ryanguo13/F1-60_722_clone/docs/PRODUCTION.md

# F1-60 722 clone — 打印与装配

WKL 60%，7.22° 楔形，嘉立创 FDM。外形对齐 Launcher 60 / F2-60，
前后壁加厚到 16 mm 以放下热熔螺母（见 [DESIGN.md](DESIGN.md)）。

## `out/` 当前件

| 文件 | 尺寸 (mm) | 说明 |
| --- | --- | --- |
| `PLATE.stl` | 285.75 × 96.10 × 1.5 | WKL ANSI，62 × 14×14 轴孔，6 个 Cherry 卫星轴槽 |
| `BOTTOM.stl` | 299.20 × 129.20 × 24.37 | 楔形底壳，2 mm 底板，前/后各 2 个 14×14 M3 热熔垫（Ø3.6 × 5.0），两条脚垫槽，后壁 USB |
| `TOP.stl` | 299.20 × 129.20 × 24.3（分型 8 → 打字 32.37） | 楔形上盖，键窗，左右桨式托台，后沿横条凹台，M3 通孔 Ø3.4 |
| `BAR.stl` | 296.20 × 8 × 3 | 后横条，无 logo，摩擦进上盖凹台 |

PCB：waffling60-DB / 任意 GH60 + ai03 UDB-C（18 × 16.5，M2 14 × 12.5）。

## 热熔（从 X4）

- 螺母：嘉立创 `M3*4*3`（Ø4 × L3）
- 打印底孔：Ø3.6 × 5.0，从 **BOTTOM 底面**开口，代嵌
- 垫：14 × 14，孔周壁 (14 − 3.6)/2 = 5.2 ≥ 3.0
- 螺钉：M3×8～10 盘头，上盖通孔 Ø3.4
- 位置：前唇 y=8、后沿 y=121.2，左右 x=50 / 249.2（不进侧壁）

## 打印

外壳 299.20 mm 长，选嘉立创 **≥ 300 mm** 工业 FDM。PLA+ / PETG，0.4 喷嘴，0.2 层高，6 墙。

| 件 | 朝向 | 支撑 |
| --- | --- | --- |
| BOTTOM | 开口朝上，底面贴床 | 无 |
| TOP | 键窗朝上 | 无 |
| PLATE | 平放 | 无 |
| BAR | 3 mm 面贴床 | 无 |

## 还没做 vs 视频里的 F1-60 722

- 前后顶棱 36° 倒角
- 上盖分型面与底壳的裙边对中（现在是平面对扣）
- 与 waffling60-DB 实物叠看 USB / 板边缘间隙
- 桨式托台高度还要按轴/PCB 实测微调
