ryanguo13/F1-60_722_clone/F1-8X+722+_+RENDER.stp

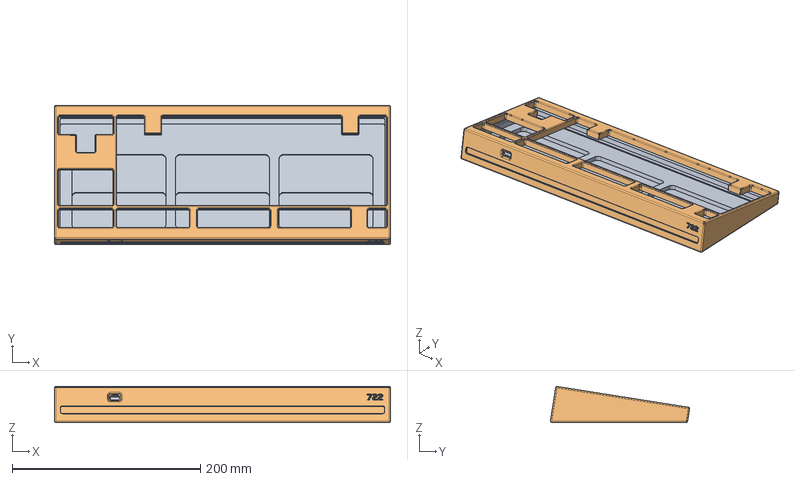
[picture p11: CAD file, 2026-10-29]
F1-8X+722+_+RENDER.stp
357.0 x 148.0 x 38.3 mm
BOTTOM
TOP
