ryanguo13/F1-60_722_clone/out/PLATE.step

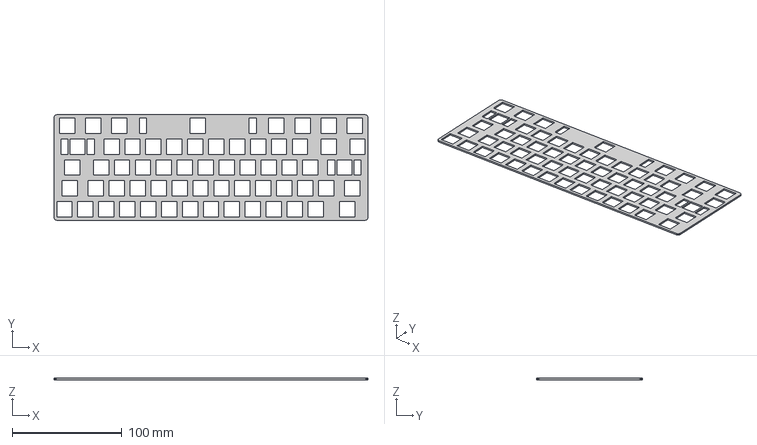
[picture p12: CAD file, 2026-10-29]
out/PLATE.step
285.8 x 96.1 x 1.50 mm
