ryanguo13/F1-60_722_clone/ref/dalco/PLATE_ANSI_V2.step

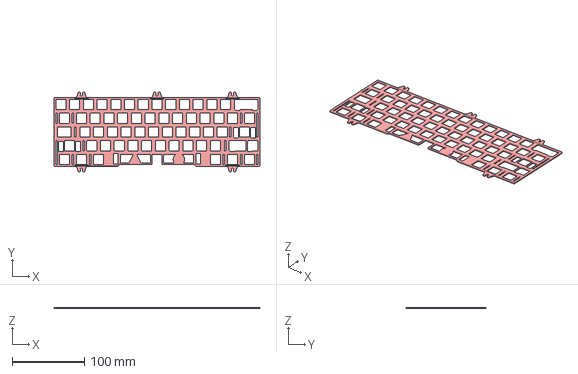
[picture p14: CAD file, 2026-10-28]
ref/dalco/PLATE_ANSI_V2.step
285.8 x 110.9 x 1.50 mm
