ryanguo13/F1-60_722_clone/ref/waffling60/waffling60-DB.step

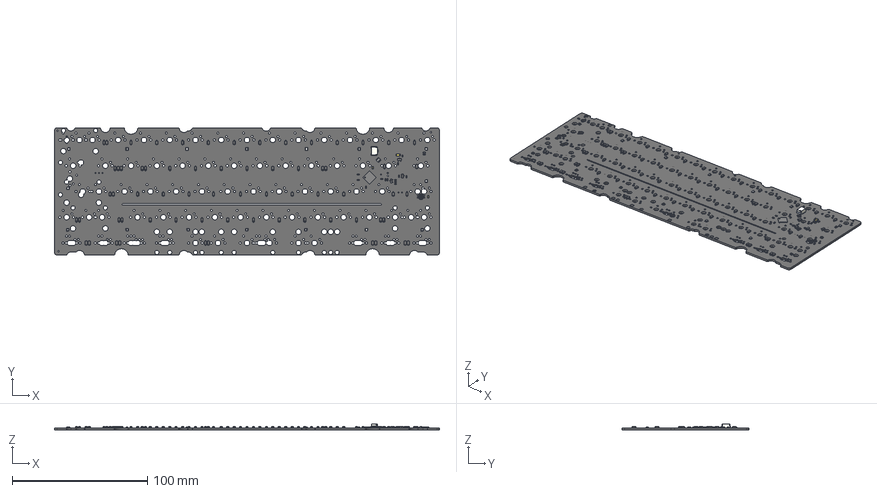
[picture p15: CAD file, 2026-10-28]
ref/waffling60/waffling60-DB.step
284.7 x 94.2 x 4.55 mm
pin x 67
pin(Mirror) x 67
icbody x 67
BODY_MF06A
LEAD_MF06A x 6
WS2812-2020 x 16
Extruded x 54
SM04B-SRSS-TB_RGB15269887
Open_CASCADE_STEP_translator_6.8_2.1
Open_CASCADE_STEP_translator_6.8_2.2.1
Thermal_Shape
Open_CASCADE_STEP_translator_6.8_2.4.1 x 48
SOT-23 x 3
LED_SK6812MINI-E
