ryanguo13/F1-60_722_clone/F2-60_RENDER.stp

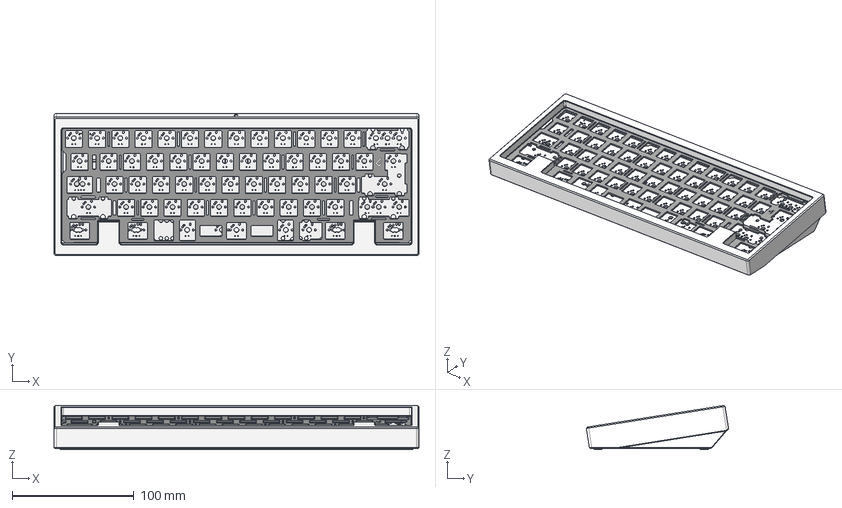
[picture p16: CAD file, 2026-10-29]
F2-60_RENDER.stp
299.2 x 116.7 x 36.1 mm
TOP
BOT
WEIGHT_1
WEIGHT_2
60_feet_284
60_feet_290
Board
HRO__TYPE-C-31-M-12
DB_BL
PLATE
PCB
