ryanguo13/F1-60_722_clone/out/BAR.step

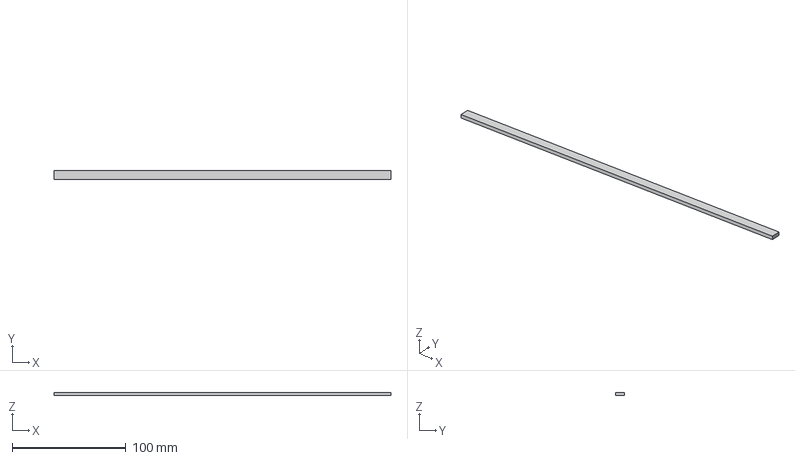
[picture p17: CAD file, 2026-10-29]
out/BAR.step
296.2 x 8.00 x 3.00 mm
