ryanguo13/F1-60_722_clone/Pro60_v5/Pro60_v5-定位板-YDKB-扩孔版.STEP

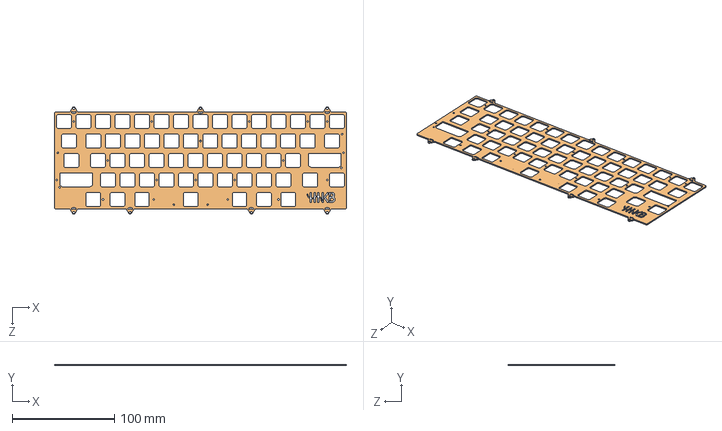
[picture p18: CAD file, 2026-10-28]
Pro60_v5/Pro60_v5-定位板-YDKB-扩孔版.STEP
285.3 x 1.20 x 104.9 mm
