ryanguo13/F1-60_722_clone/ref/dalco/BOTTOM_V3.step

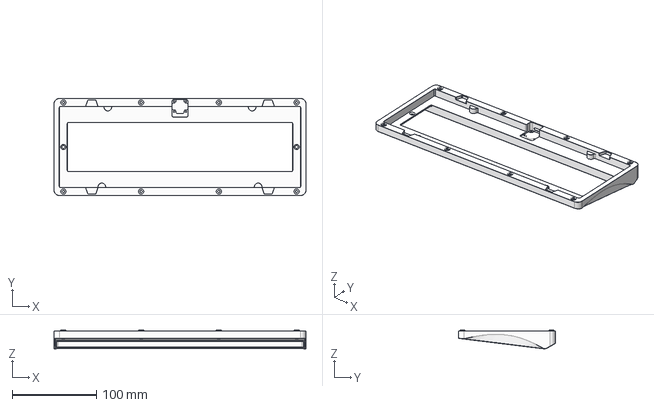
[picture p19: CAD file, 2026-10-28]
ref/dalco/BOTTOM_V3.step
299.4 x 115.2 x 22.3 mm
