ryanguo13/F1-60_722_clone/ref/waffling60/waffling60-MXHS-ANSI.step

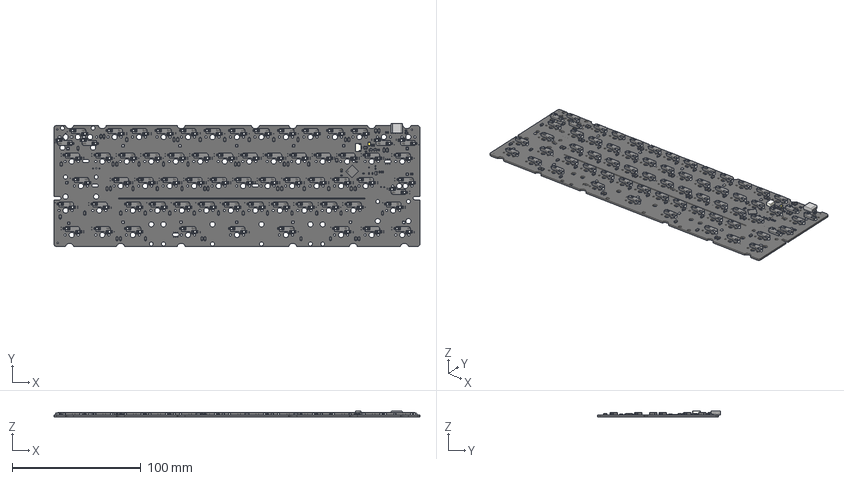
[picture p20: CAD file, 2026-10-28]
ref/waffling60/waffling60-MXHS-ANSI.step
284.7 x 95.8 x 4.80 mm
WS2812-2020 x 16
Extruded x 60
kailh_socket_mx x 66
Open_CASCADE_STEP_translator_6.8_1.1.1
Open_CASCADE_STEP_translator_6.8_1.1.2
Open_CASCADE_STEP_translator_6.8_1.2.1
SOT-23 x 3
Open_CASCADE_STEP_translator_6.8_2.1
Open_CASCADE_STEP_translator_6.8_2.2.1
Thermal_Shape
Open_CASCADE_STEP_translator_6.8_2.4.1 x 48
SM04B-SRSS-TB_RGB15269887
pin x 64
pin(Mirror) x 64
icbody x 64
BODY_MF06A
LEAD_MF06A x 6
HRO__TYPE-C-31-M-12
