ryanguo13/F1-60_722_clone/out/TOP.step

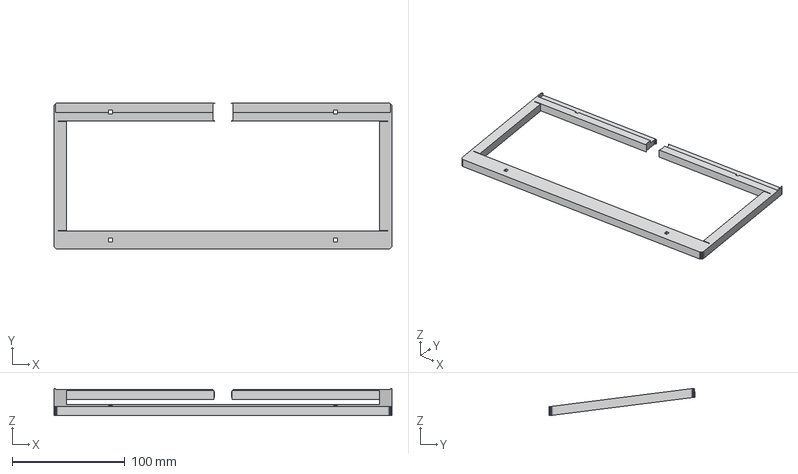
[picture p21: CAD file, 2026-10-29]
out/TOP.step
299.2 x 129.2 x 24.3 mm
