ryanguo13/F1-60_722_clone/ref/dalco/WEIGHT_GT_V3.step

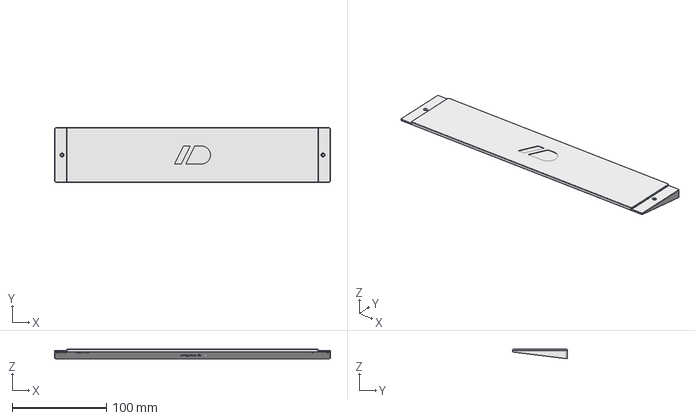
[picture p22: CAD file, 2026-10-28]
ref/dalco/WEIGHT_GT_V3.step
292.9 x 58.1 x 10.1 mm
