ryanguo13/F1-60_722_clone/ref/udb_c3.step

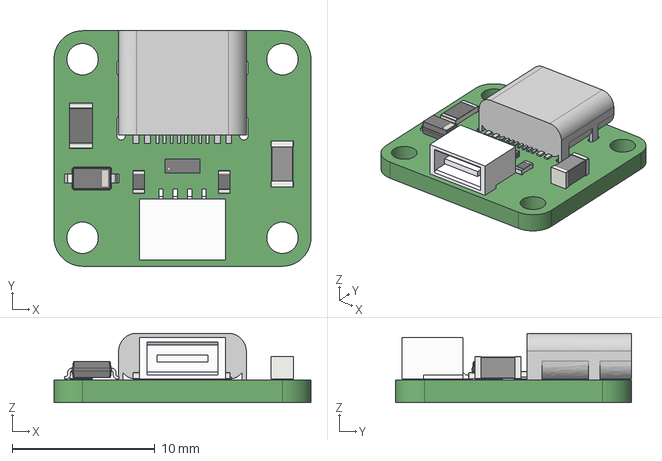
[picture p23: CAD file, 2026-10-28]
ref/udb_c3.step
18.0 x 16.5 x 4.86 mm
