ryanguo13/F1-60_722_clone/out/BOTTOM.step

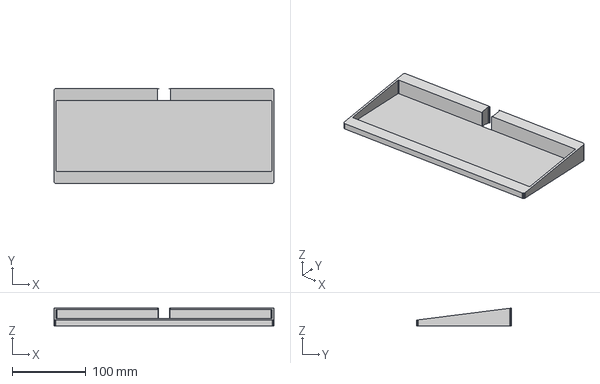
[picture p24: CAD file, 2026-10-29]
out/BOTTOM.step
299.2 x 129.2 x 24.4 mm
