ryanguo13/F1-60_722_clone/Pro60_v5/Pro60_v5-上盖-无加固支撑.STEP

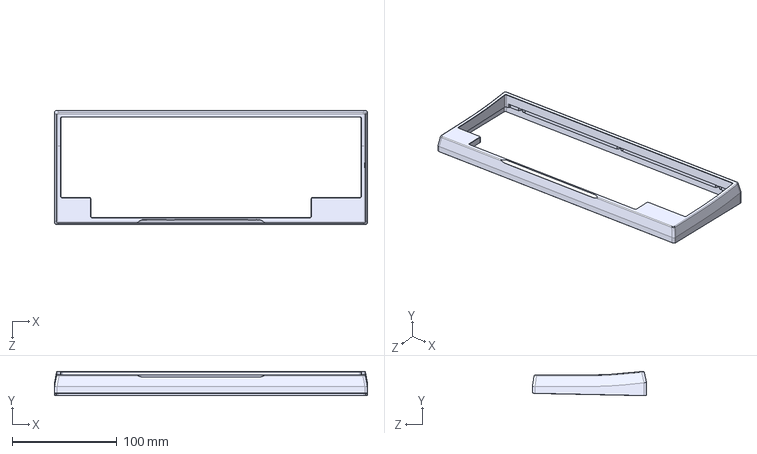
[picture p27: CAD file, 2026-10-28]
Pro60_v5/Pro60_v5-上盖-无加固支撑.STEP
298.1 x 23.3 x 108.8 mm
