ryanguo13/F1-60_722_clone/ref/dalco/WEIGHT_G2_V2.step

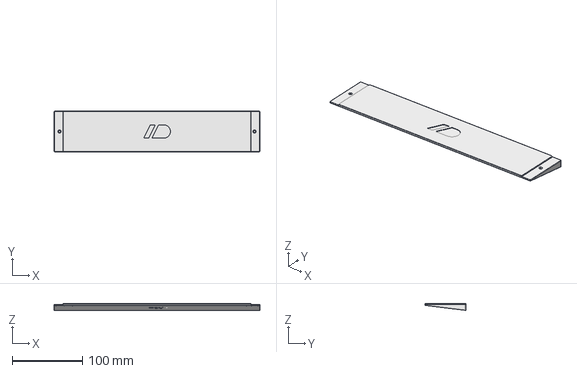
[picture p28: CAD file, 2026-10-28]
ref/dalco/WEIGHT_G2_V2.step
292.9 x 58.1 x 9.63 mm
