ryanguo13/F1-60_722_clone/Pro60_v5/Pro60_v5-底壳.STEP

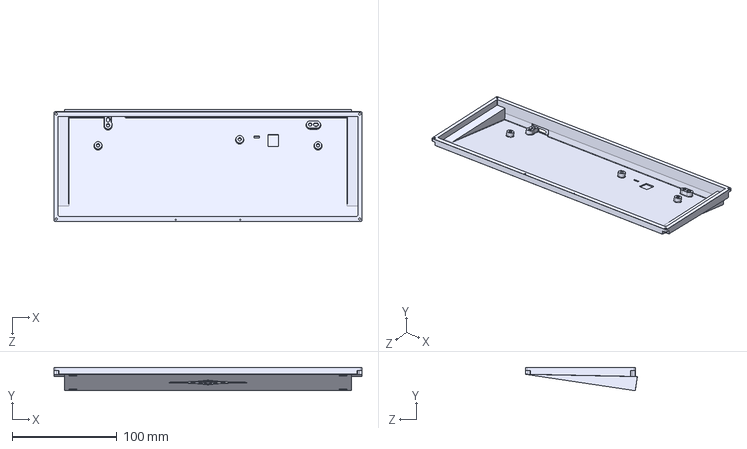
[picture p29: CAD file, 2026-10-28]
Pro60_v5/Pro60_v5-底壳.STEP
294.1 x 22.3 x 106.8 mm
