ryanguo13/F1-60_722_clone/ref/dalco/ACCENT_V2.step

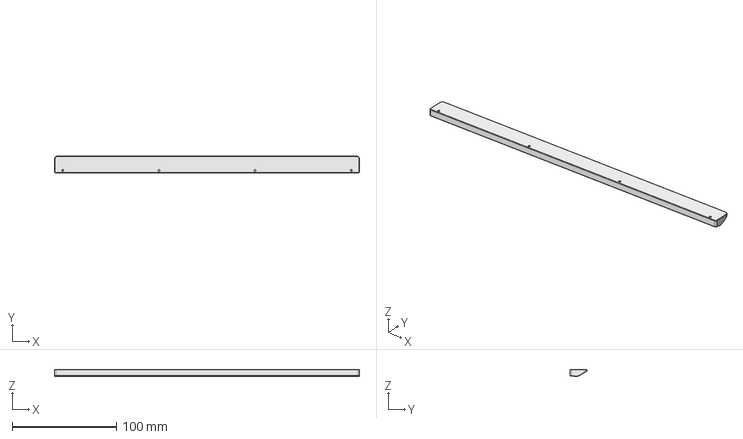
[picture p30: CAD file, 2026-10-28]
ref/dalco/ACCENT_V2.step
292.9 x 16.5 x 6.74 mm
