ryanguo13/F1-60_722_clone/ref/dalco/TOP_WINKEY_V2.step

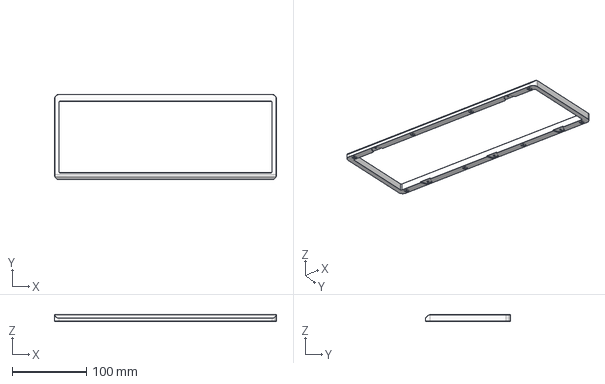
[picture p31: CAD file, 2026-10-28]
ref/dalco/TOP_WINKEY_V2.step
299.4 x 115.2 x 9.00 mm
