ryanguo13/F1-60_722_clone/(list of files, cad)

Other CAD files:
Pro60_v5/Pro60_v5-底壳-后侧大圆角.STEP
Pro60_v5/定位板-YDKB-扩孔版.DWG
ref/dalco/WEIGHT_REGULAR_V3.step
out/BAR.stl
out/BOTTOM.stl
out/PLATE.stl
out/TOP.stl
ref/dalco/BOTTOM_V2.step
ref/dalco/WEIGHT_REGULAR_V2.step
