ryanguo13/F1-60_722_clone/ref/waffling60/mxhs_assembly.pdf

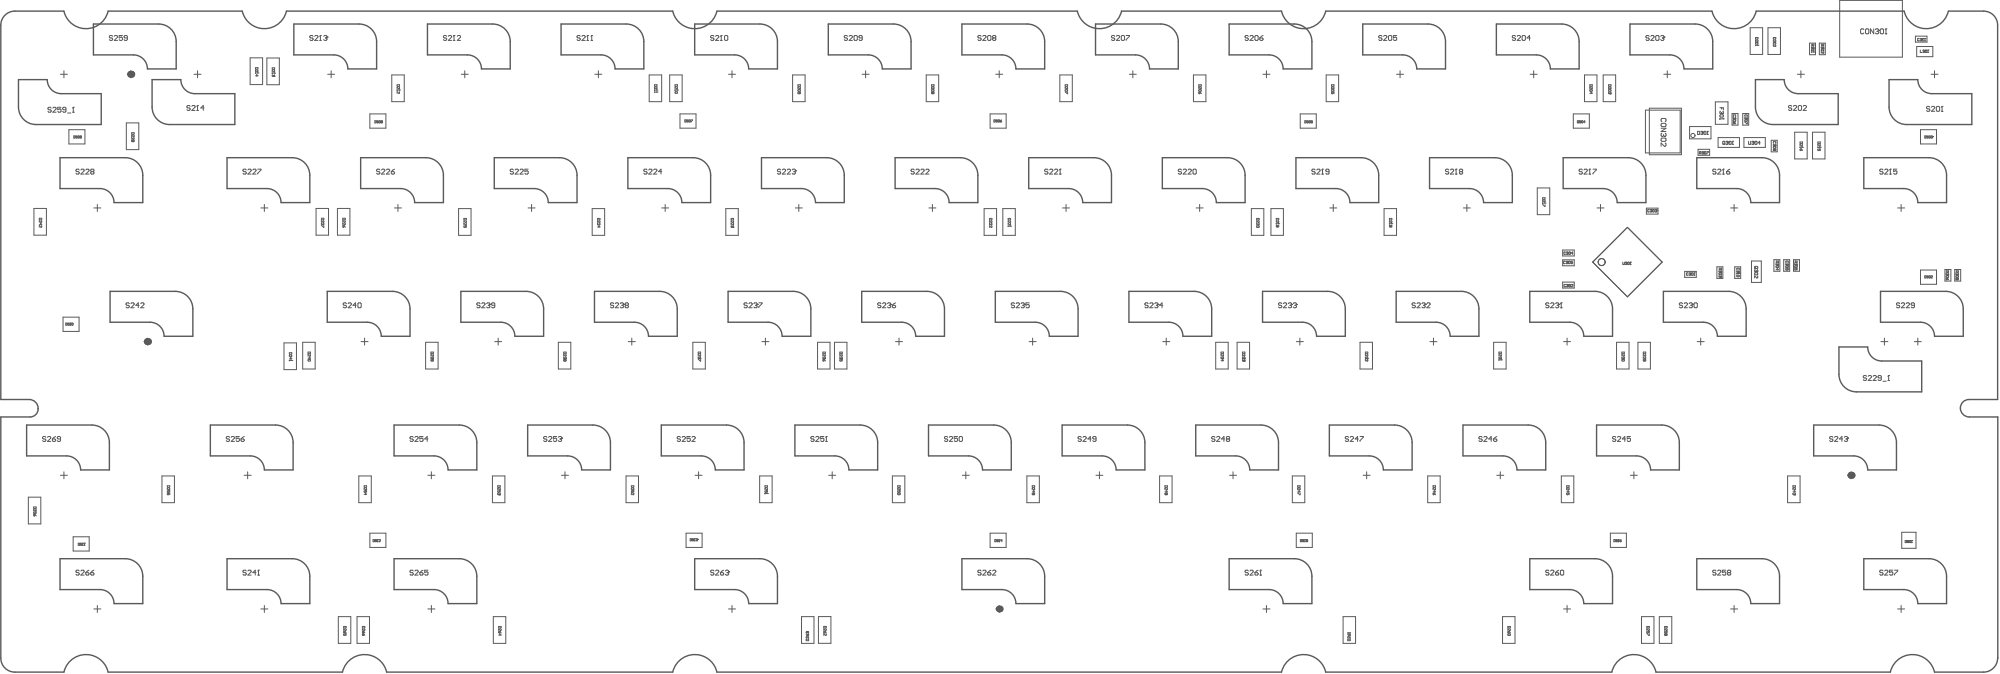
[picture p32: page 1]
