ryanguo13/F1-60_722_clone/ref/waffling60/waffling60-DB-assembly.pdf

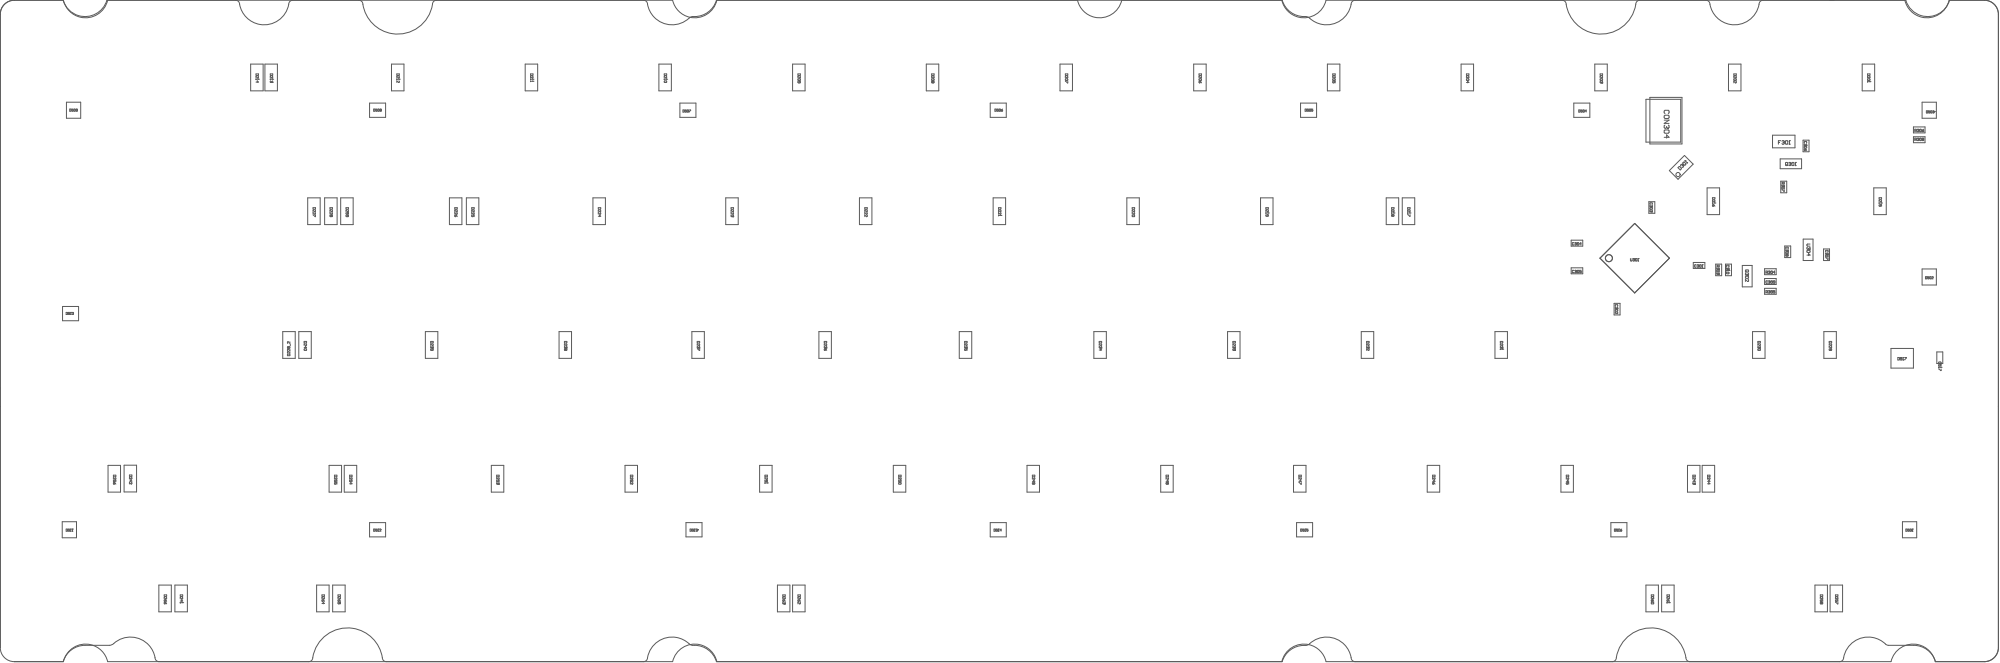
[picture p33: page 1]
