ryanguo13/F1-60_722_clone/(list of files, drawings)

Other design files:
ref/waffling60/pcb_holes.json
