ryanguo13/F1-60_722_clone/(commit log)

2026-10-28 Initial scaffold: parametric Fusion script, waffling60/959 Mini references
    [ACCENT_V2.step, BOTTOM_V2.step, BOTTOM_V3.step, PLATE_ANSI_V2.step, Pro60_v5-上盖-无加固支撑.STEP, Pro60_v5-上盖.STEP, Pro60_v5-定位板-YDKB-扩孔版.STEP, Pro60_v5-底壳-后侧大圆角.STEP]
2026-10-28 Part-based builder; native sketch circles for switch holes
2026-10-28 Sketched-on-XY builder: short sketches, one loop per sketch, circles cut reliably
    [udb_c3.step]
2026-10-29 Restart modelling path: layout-space plan generator; add F2-60 / F1-8X 722 references
    [F1-8X+722+_+RENDER.stp, F1-8X_722_RENDER.stp, F2-60_RENDER.stp]
2026-10-29 Align WKL plate to Dalco 959 Mini ANSI and export STEP/STL
    Layout is now the Dalco 15u plate envelope (285.75 x 110.85) inside an
    F2-60-sized case (~299 x 117). 62 switch squares plus 6 Cherry stab
    slots cut cleanly in Fusion 2706.
    [PLATE.step, PLATE.stl]
2026-10-29 Add printable TOP/BOTTOM trays and F1-8X square feet pockets
    Bottom: 299 x 117 x 16 mm tray, inner well, weight well (1.2 mm floor),
    ai03 uDB rear window, four M3 heat-set bores, four 10 x 8 mm feet
    recesses (F1-8X 722 glued square pads). Top: 9 mm bezel, switch
    ceiling opening, rear-wall uDB window, M3 clearance.
    [BOTTOM.step, BOTTOM.stl, TOP.step, TOP.stl]
2026-10-29 Checkpoint: WKL tray set with JLC M3 pads, feet, and rear bar
    Printable rectangular TOP/BOTTOM/PLATE/BAR matching Dalco 15u + F2-60
    envelope. Heat-set pads follow X4 (嘉立创 M3*4*3, Ø3.6x5, 14x14).
    Rear accent bar has no Geon badge. 7.22° wedge and paddle plate still open.
    [BAR.step, BAR.stl, BOTTOM.step, BOTTOM.stl, TOP.step, TOP.stl]
2026-10-29 Checkpoint: 7.22° WKL wedge case with front/back M3 inserts
    Replace the rectangular tray with a typed F1-60 722 silhouette:
    299.20 × 129.20 mm, 7.22° wedge, R3 corners, 3 mm side walls and
    16 mm front/back lips so 14×14 JLC M3 heat-set pads miss the plate.
    TOP/BOTTOM split parallel to the typing plane; WKL plate, rear bar,
    and USB window for ai03 UDB-C.
    [BAR.step, BAR.stl, BOTTOM.step, BOTTOM.stl, PLATE.step, PLATE.stl, TOP.step, TOP.stl]
